Solomute/feeder/Releases/STL/thimble_1x.stl

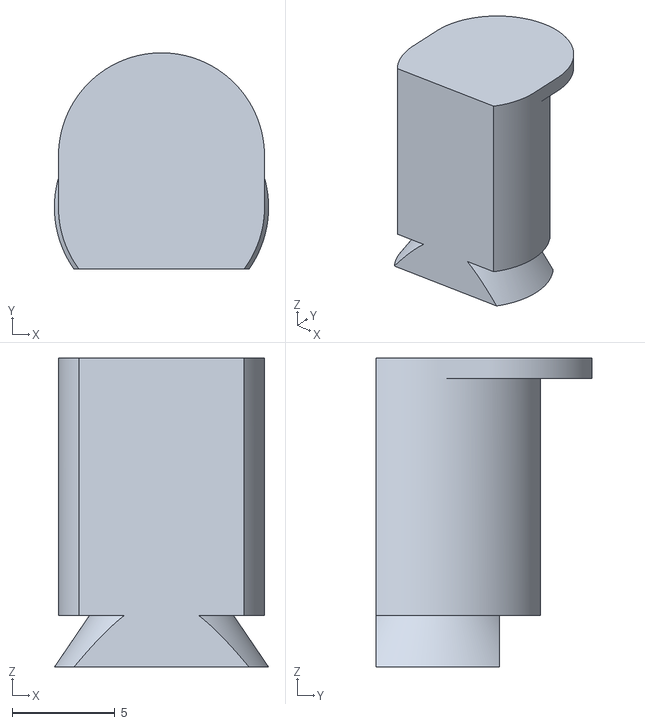
[picture p1: CAD file, 2025-03-03]
Releases/STL/thimble_1x.stl
10.4 x 10.5 x 15.0
