Solomute/feeder/Releases/STL/frame-12.step

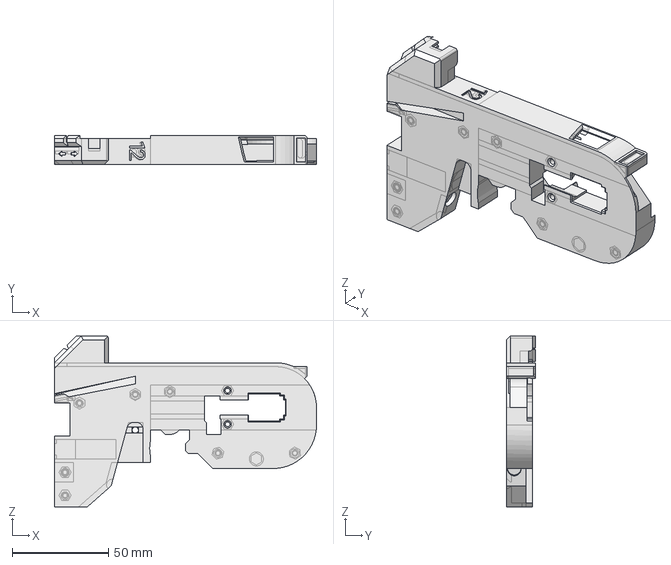
[picture p2: CAD file, 2025-03-03]
Releases/STL/frame-12.step
136.2 x 15.0 x 88.9 mm
