Solomute/feeder/Releases/STL/spool-holder_1x.stl

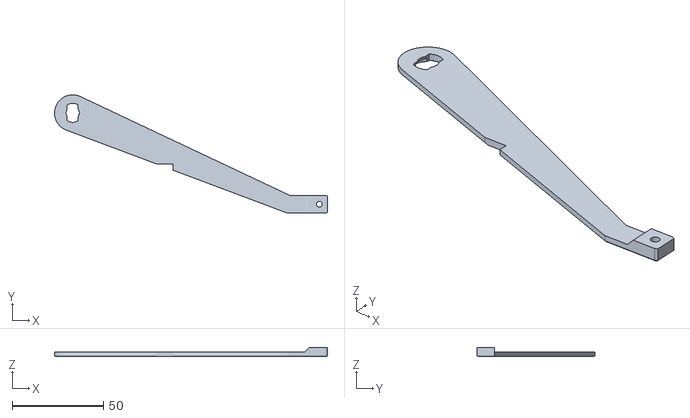
[picture p3: CAD file, 2025-03-03]
Releases/STL/spool-holder_1x.stl
150.0 x 65.0 x 5.00
