Solomute/feeder/Releases/STL/drive-motor-cover_1x.stl

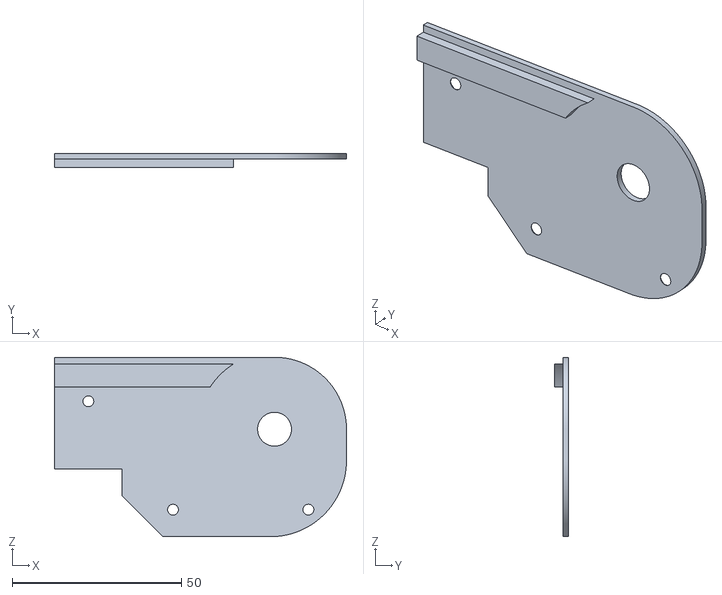
[picture p4: CAD file, 2025-03-03]
Releases/STL/drive-motor-cover_1x.stl
86.2 x 4.10 x 53.0
