Solomute/feeder/Releases/STL/release-lever_1x.stl

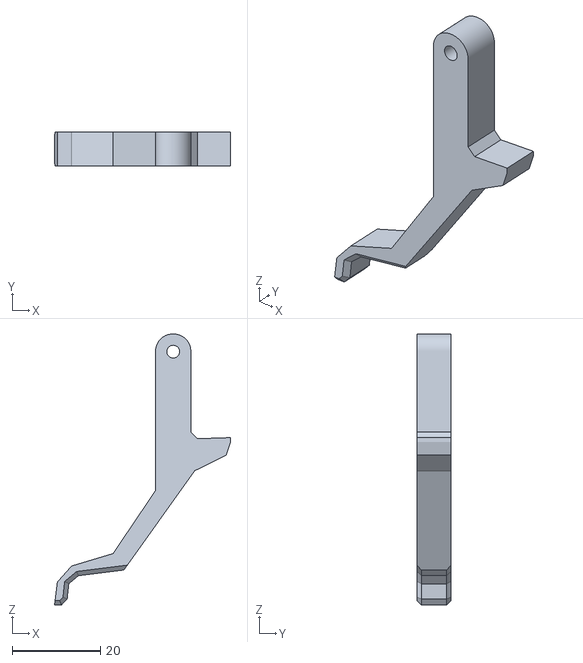
[picture p5: CAD file, 2025-03-03]
Releases/STL/release-lever_1x.stl
39.9 x 7.75 x 61.5
