Solomute/feeder/Releases/STL/drive-motor-bracket_1x.stl

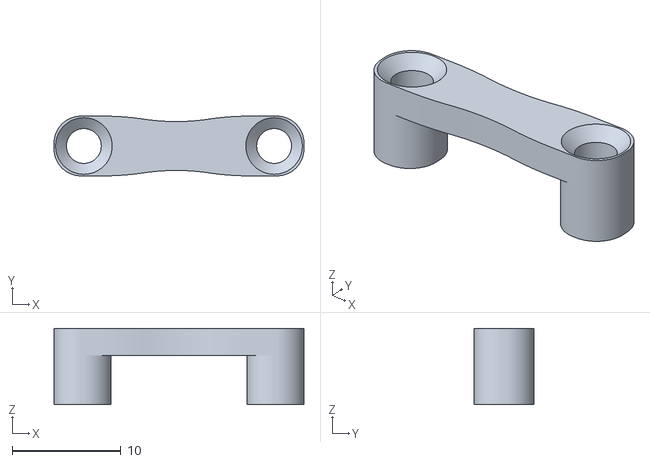
[picture p6: CAD file, 2025-03-03]
Releases/STL/drive-motor-bracket_1x.stl
23.0 x 5.50 x 7.00
