Solomute/feeder/Releases/STL/peel-gear_2x.stl

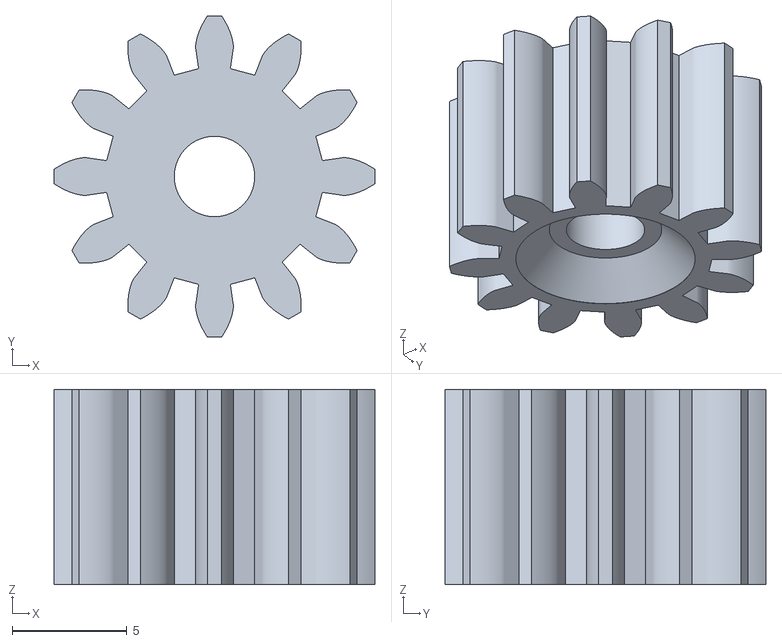
[picture p8: CAD file, 2025-03-03]
Releases/STL/peel-gear_2x.stl
14.0 x 14.0 x 8.50
