Solomute/feeder/Releases/STL/tape-guide_1x.stl

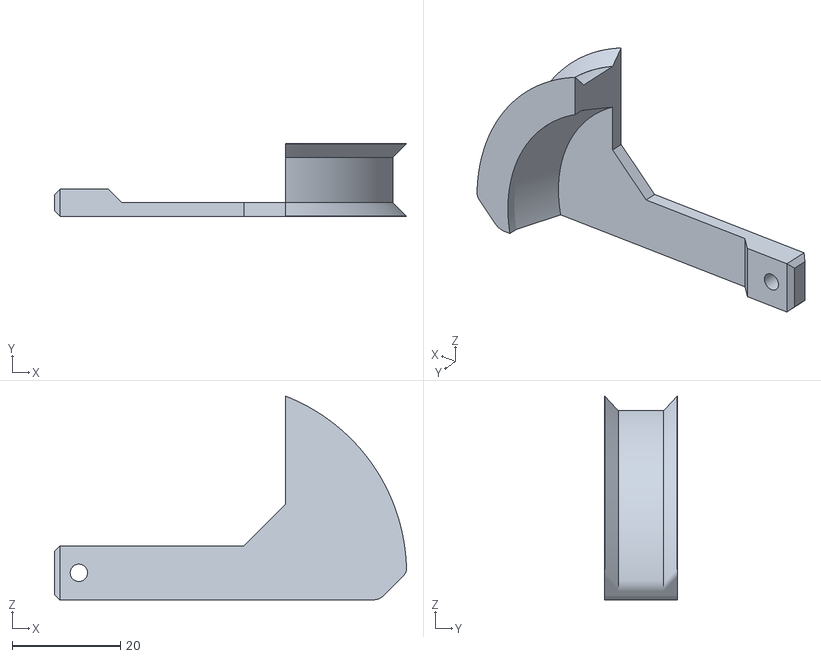
[picture p9: CAD file, 2025-03-03]
Releases/STL/tape-guide_1x.stl
65.0 x 13.4 x 37.6
