Solomute/feeder/pcb/mobo/mobo.kicad_pcb

## KiCad design pcb/mobo/mobo.kicad_pcb (2025-03-03)

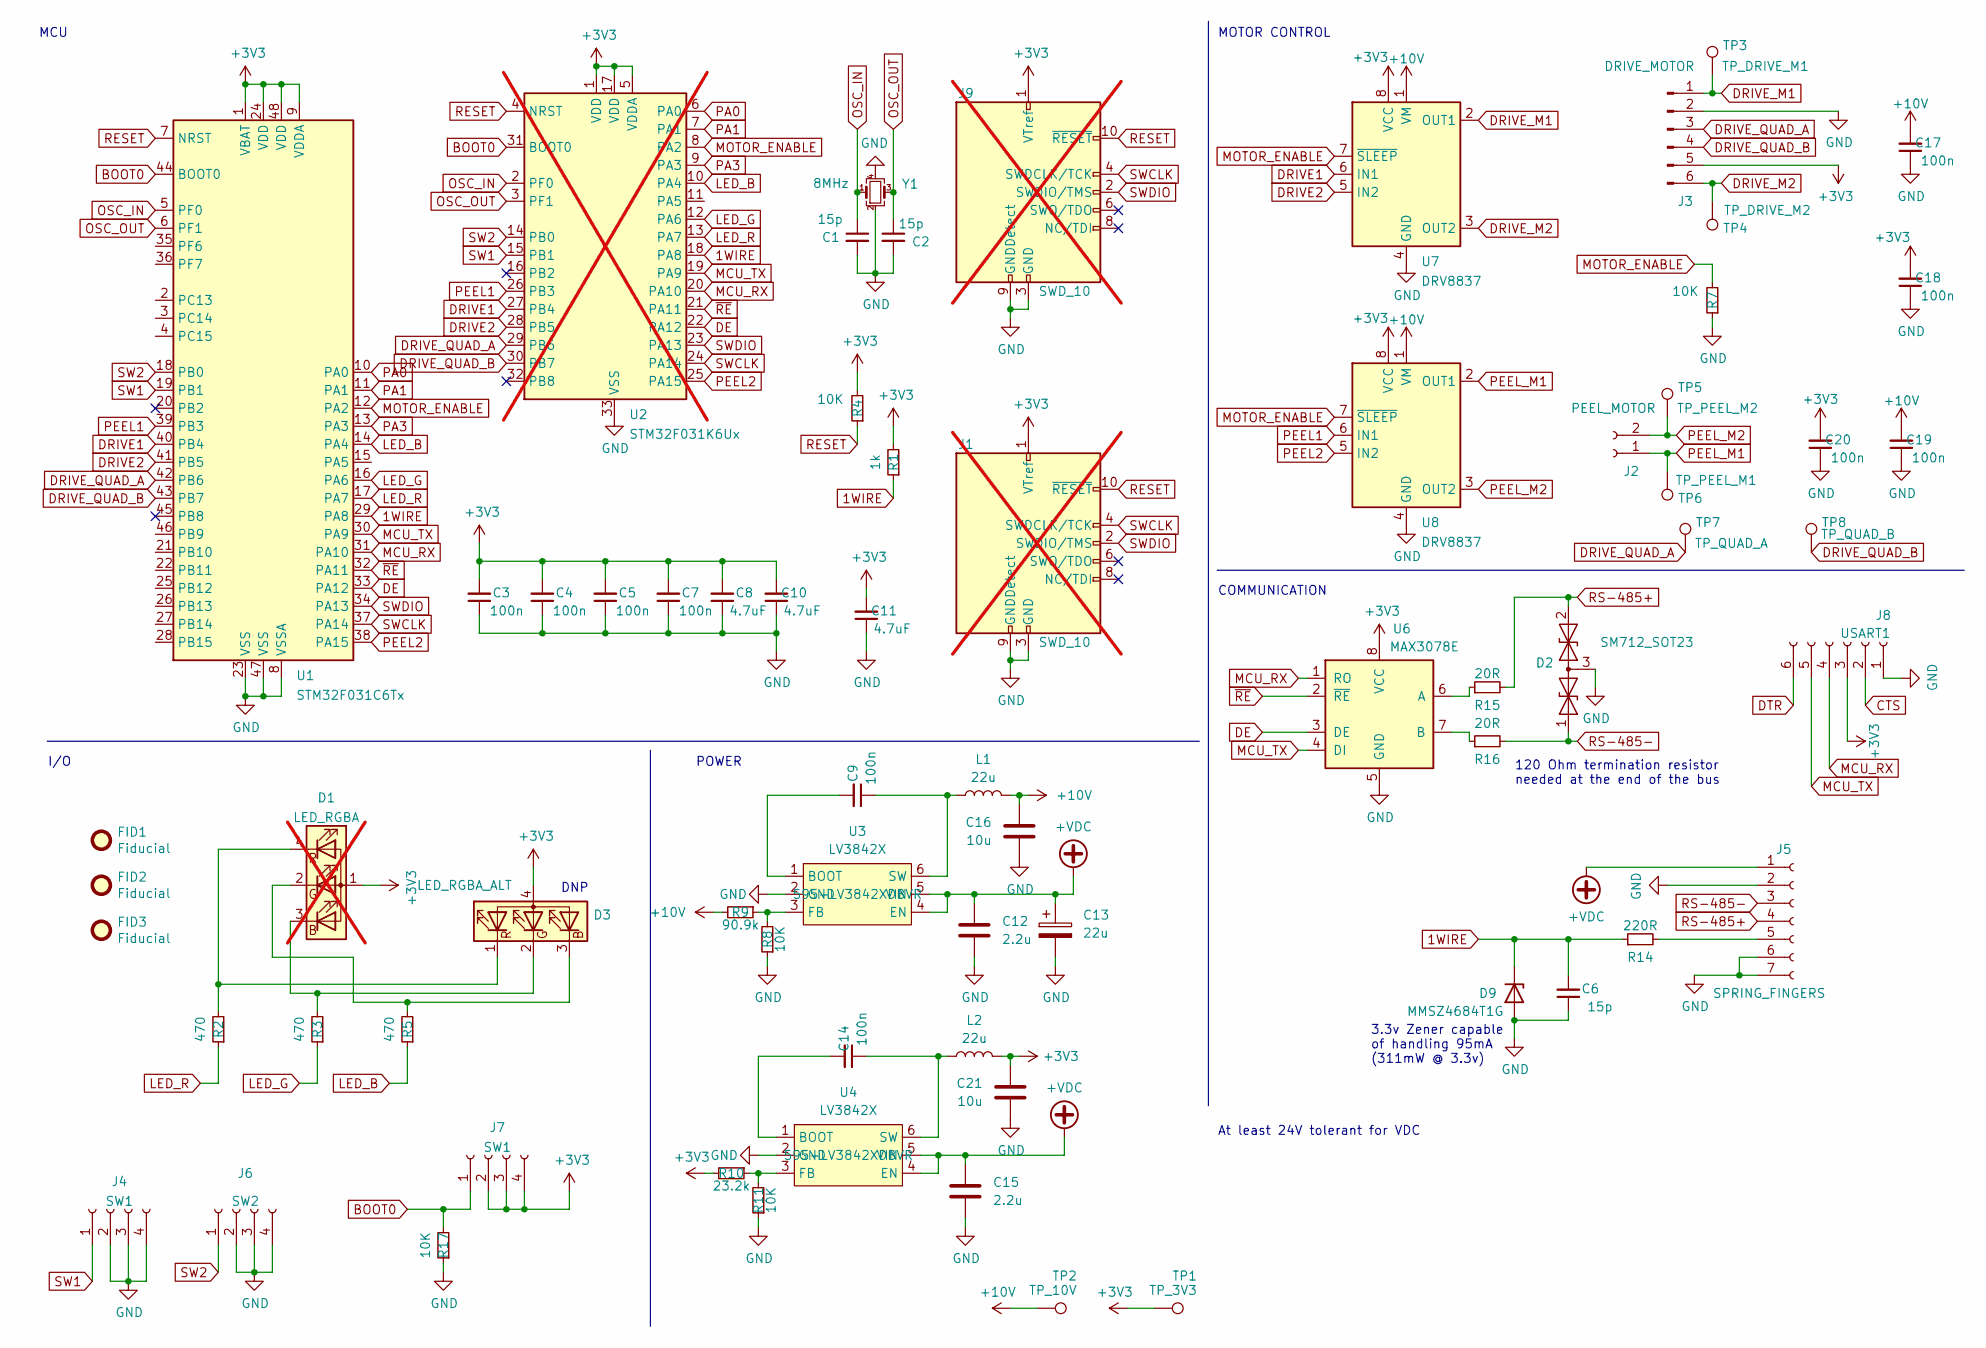
[picture p10: schematic mobo.kicad_sch, LumenPnP Feeder Control Board]

Parts:
C1, C2: 15p; C_0805_2012Metric; Mouser Part Number 603-CC805JRNPO9BN150; JLCPCB C1794
C3, C4, C5, C7, C9, C14, C17, C18, C19, C20: 100n; C_0805_2012Metric; Mouser Part Number 791-0805B104K500CT; JLCPCB C49678
C6: 15p; C_0805_2012Metric; Mouser Part Number 603-CC805JRNPO9BN150; JLCPCB C49678
C8, C10, C11: 4.7uF; C_0805_2012Metric; Mouser Part Number 187-CL21A475KPFNNNG; JLCPCB C49678
C12, C15: 2.2u; C_0805_2012Metric; Mouser Part Number 963-UMK212ABJ225KG-T
C13: 22u; CP_Elec_5x5.3; Mouser Part Number 80-EDK226M035A9DAA
C16, C21: 10u; C_0805_2012Metric; Mouser Part Number 187-CL21A106KOQNNNE
D1: LED_RGBA; MHS110FRGBCT; not fitted
D2: SM712_SOT23; SOT-23; Mouser Part Number 576-SM712-02HTG; LCSC C521963
D3: LED_RGBA_ALT; LED_LiteOn_LTST-C19HE1WT; Mouser Part Number 859-LTSTC19HE1WTRS1
D9: MMSZ4684T1G; D_SOD-123; Mouser Part Number 863-MMSZ4684T1G; JLCPCB MMSZ4684T1G
FID1, FID2, FID3: Fiducial; Fiducial_1mm_Mask2mm
J1: SWD_10; PinHeader_2x05_P1.27mm_Vertical_SMD; not fitted
J2: PEEL_MOTOR; Molex_PicoBlade_53261-0271_1x02-1MP_P1.25mm_Horizontal; Mouser Part Number 538-53261-0271; LCSC C2845379
J3: DRIVE_MOTOR; Molex_PicoBlade_53261-0671_1x06-1MP_P1.25mm_Horizontal; Mouser Part Number 538-53261-0671; LCSC C2845383
J4, J7: SW1; 1TS003B-1400-3500A-CT; Mouser Part Number 179-TS314635B260RASM; LCSC C319392
J5: SPRING_FINGERS; AVX-9155-005-541; Mouser Part Number 581-009155005541006
J6: SW2; 1TS003B-1400-3500A-CT; Mouser Part Number 179-TS314635B260RASM; LCSC C319392
J8: USART1; UART_FRICTION_FIT
J9: SWD_10; SWD-No-Paste; not fitted
L1, L2: 22u; L_4018; Mouser Part Number 963-NRS4018T220MDGJV
R1: 1k; R_0805_2012Metric; Mouser Part Number 708-RMCF0805FG1K00; JLCPCB C17513
R2, R3, R5: 470; R_0805_2012Metric; Mouser Part Number 603-RC0805JR-10470RL; JLCPCB C17710
R4, R7, R8, R11, R17: 10K; R_0805_2012Metric; Mouser Part Number 603-RE0805FRE0710KL; JLCPCB C17513
R9: 90.9k; R_0805_2012Metric; Mouser Part Number 71-CRCW0805-90.9K-E3
R10: 23.2k; R_0805_2012Metric; Mouser Part Number 603-RC0805FR-0723K2L
R14: 220R; R_0805_2012Metric; Mouser Part Number 667-ERJ-P06J221V
R15, R16: 20R; R_0805_2012Metric; Mouser Part Number 660-RK73H2ATTDD20R0F
TP1: TP_3V3; TestPoint_Pad_D2.0mm
TP2: TP_10V; TestPoint_Pad_D2.0mm
TP3: TP_DRIVE_M1; TestPoint_Pad_D2.0mm
TP4: TP_DRIVE_M2; TestPoint_Pad_D2.0mm
TP5: TP_PEEL_M2; TestPoint_Pad_D2.0mm
TP6: TP_PEEL_M1; TestPoint_Pad_D2.0mm
TP7: TP_QUAD_A; TestPoint_Pad_D2.0mm
TP8: TP_QUAD_B; TestPoint_Pad_D2.0mm
U1: STM32F031C6Tx; LQFP-48_7x7mm_P0.5mm; Mouser Part Number 511-STM32F031C6T6
U2: STM32F031K6Ux; QFN-32-No-Paste; not fitted
U3, U4: LV3842X; SOT-23-6; Mouser Part Number 595-LV3842XDBVR
U6: MAX3078E; SOIC-8_3.9x4.9mm_P1.27mm; Mouser Part Number 701-SP3078EEN-L/TR; JLCPCB C40031
U7, U8: DRV8837; WSON-8-1EP_2x2mm_P0.5mm_EP0.9x1.6mm; Mouser Part Number 595-DRV8837CDSGR
Y1: 8MHz; Crystal_SMD_3225-4Pin_3.2x2.5mm_HandSoldering; Mouser Part Number 520-80833B2QCVYTR; JLCPCB C253751

Connections:
1WIRE: C6.2, D9.1 (K), R1.1, R14.1, U1.29 (PA8), U2.18 (PA8)
+3V3: C3.2, C4.2, C5.2, C7.2, C8.2, C10.2, C11.2, C18.2, C20.2, C21.1, D1.1 (A), D3.4 (A), J1.1 (VTref), J3.5, J7.2, J7.3, J7.4, J8.3, J9.1 (VTref), L2.2, R1.2, R4.2, R10.2, TP1.1, U1.1 (VBAT), U1.9 (VDDA), U1.24 (VDD), U1.48 (VDD), U2.1 (VDD), U2.5 (VDDA), U2.17 (VDD), U6.8 (VCC), U7.8 (VCC), U8.8 (VCC)
+10V: C16.1, C17.2, C19.2, L1.2, R9.2, TP2.1, U7.1 (VM), U8.1 (VM)
+VDC: C12.1, C13.1, C15.1, J5.1, U3.4 (EN), U3.5 (VIN), U4.4 (EN), U4.5 (VIN)
BOOT0: J7.1, R17.2, U1.44 (BOOT0), U2.31 (BOOT0)
CTS: J8.2
DE: U1.33 (PA12), U2.22 (PA12), U6.3 (DE)
DRIVE1: U1.40 (PB4), U2.27 (PB4), U7.6 (IN1)
DRIVE2: U1.41 (PB5), U2.28 (PB5), U7.5 (IN2)
DRIVE_M1: J3.1, TP3.1, U7.2 (OUT1)
DRIVE_M2: J3.6, TP4.1, U7.3 (OUT2)
DRIVE_QUAD_A: J3.3, TP7.1, U1.42 (PB6), U2.29 (PB6)
DRIVE_QUAD_B: J3.4, TP8.1, U1.43 (PB7), U2.30 (PB7)
DTR: J8.6
GND: C1.2, C2.2, C3.1, C4.1, C5.1, C6.1, C7.1, C8.1, C10.1, C11.1, C12.2, C13.2, C15.2, C16.2, C17.1, C18.1, C19.1, C20.1, C21.2, D2.3 (common), D9.2 (A), J1.3 (GND), J1.5 (GND), J1.9 (GNDDetect), J3.2, J4.2, J4.3, J4.4, J5.2, J5.6, J5.7, J6.2, J6.3, J6.4, J8.1, J9.3 (GND), J9.5 (GND), J9.9 (GNDDetect), R7.1, R8.1, R11.1, R17.1, U1.8 (VSSA), U1.23 (VSS), U1.47 (VSS), U2.33 (VSS), U3.2 (GND), U4.2 (GND), U6.5 (GND), U7.4 (GND), U7.9 (GND), U8.4 (GND), U8.9 (GND), Y1.2, Y1.4
LED_B: R5.1, U1.14 (PA4), U2.10 (PA4)
LED_G: R3.1, U1.16 (PA6), U2.12 (PA6)
LED_R: R2.1, U1.17 (PA7), U2.13 (PA7)
MCU_RX: J8.4, U1.31 (PA10), U2.20 (PA10), U6.1 (RO)
MCU_TX: J8.5, U1.30 (PA9), U2.19 (PA9), U6.4 (DI)
MOTOR_ENABLE: R7.2, U1.12 (PA2), U2.8 (PA2), U7.7 (~SLEEP), U8.7 (~SLEEP)
unnamed: D1.3 (BK), D3.2 (GK), R3.2
unnamed: D1.2 (GK), D3.3 (BK), R5.2
unnamed: D1.4 (RK), D3.1 (RK), R2.2
unnamed: J5.5, R14.2
unnamed: C9.2, U3.1 (BOOT)
unnamed: R8.2, R9.1, U3.3 (FB)
unnamed: C9.1, L1.1, U3.6 (SW)
unnamed: C14.2, U4.1 (BOOT)
unnamed: R10.1, R11.2, U4.3 (FB)
unnamed: C14.1, L2.1, U4.6 (SW)
unnamed: R15.1, U6.6 (A)
unnamed: R16.1, U6.7 (B)
OSC_IN: C1.1, U1.5 (PF0), U2.2 (PF0), Y1.1
OSC_OUT: C2.1, U1.6 (PF1), U2.3 (PF1), Y1.3
PA0: U1.10 (PA0), U2.6 (PA0)
PA1: U1.11 (PA1), U2.7 (PA1)
PA3: U1.13 (PA3), U2.9 (PA3)
PEEL1: U1.39 (PB3), U2.26 (PB3), U8.6 (IN1)
PEEL2: U1.38 (PA15), U2.25 (PA15), U8.5 (IN2)
PEEL_M1: J2.1, TP6.1, U8.2 (OUT1)
PEEL_M2: J2.2, TP5.1, U8.3 (OUT2)
RESET: J1.10 (~RESET), J9.10 (~RESET), R4.1, U1.7 (NRST), U2.4 (NRST)
RS-485+: D2.2 (A2), J5.4, R15.2
RS-485-: D2.1 (A1), J5.3, R16.2
SW1: J4.1, U1.19 (PB1), U2.15 (PB1)
SW2: J6.1, U1.18 (PB0), U2.14 (PB0)
SWCLK: J1.4 (SWDCLK/TCK), J9.4 (SWDCLK/TCK), U1.37 (PA14), U2.24 (PA14)
SWDIO: J1.2 (SWDIO/TMS), J9.2 (SWDIO/TMS), U1.34 (PA13), U2.23 (PA13)
~RE: U1.32 (PA11), U2.21 (PA11), U6.2 (~RE)

Notes on the sheet:
I/O
DNP
COMMUNICATION
MOTOR CONTROL
POWER
3.3v Zener capable of handling 95mA (311mW @ 3.3v)
At least 24V tolerant for VDC
MCU
120 Ohm termination resistor needed at the end of the bus

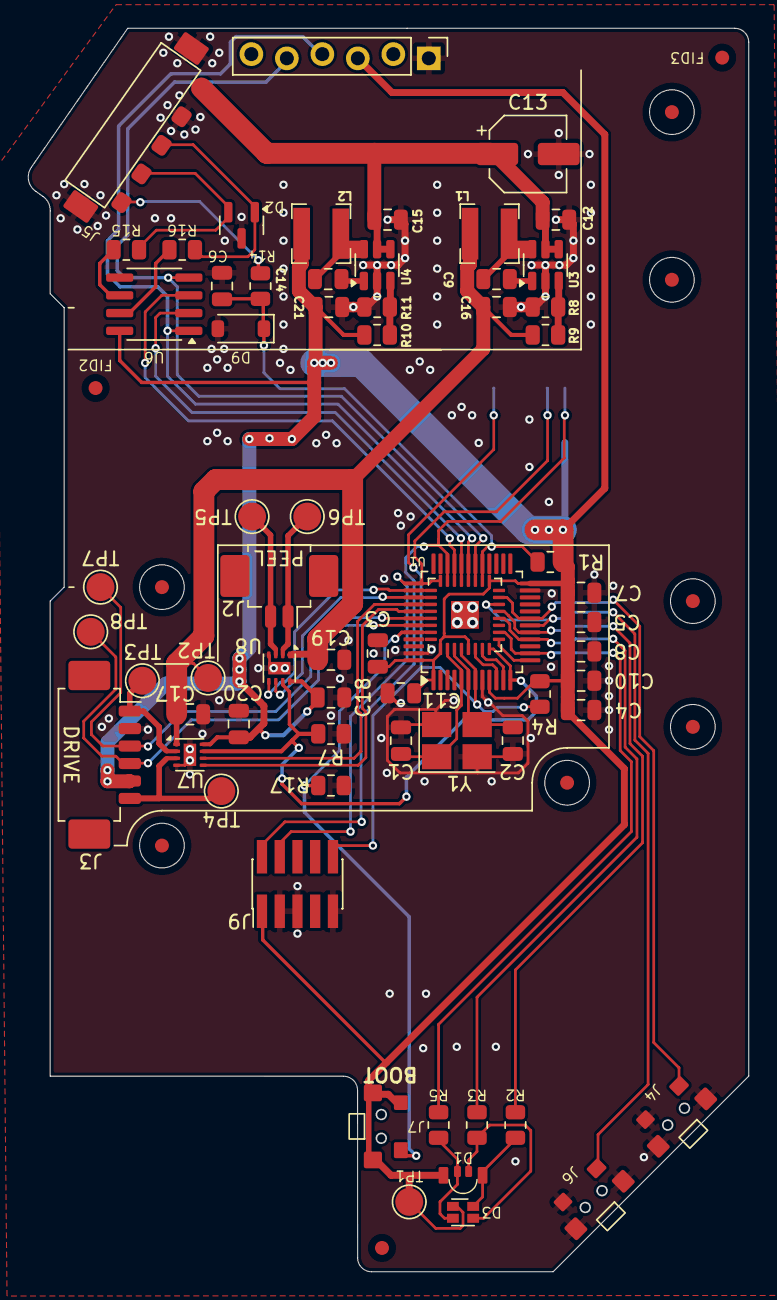
[picture p11: board mobo.kicad_pcb from above]

Board: 2 copper layers, 51.6 x 89.0 mm, 76 parts (1 on the bottom side), 48 nets.

Other parts of the board:
H1, H2, H3, H4, H5, H6, H7: M3_Countersunk
