Solomute/feeder/(commit log)

2025-03-03 Power supply mangling
    [drive-motor-bracket_1x.stl, drive-motor-cover_1x.stl, frame-12.step, frame-8.step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]
2025-03-03 add bom export
    [mobo.csv]
